jalinei/SPIN/KiCAD_files/spin.kicad_pcb

## KiCad design KiCAD_files/spin.kicad_pcb (2025-09-29)

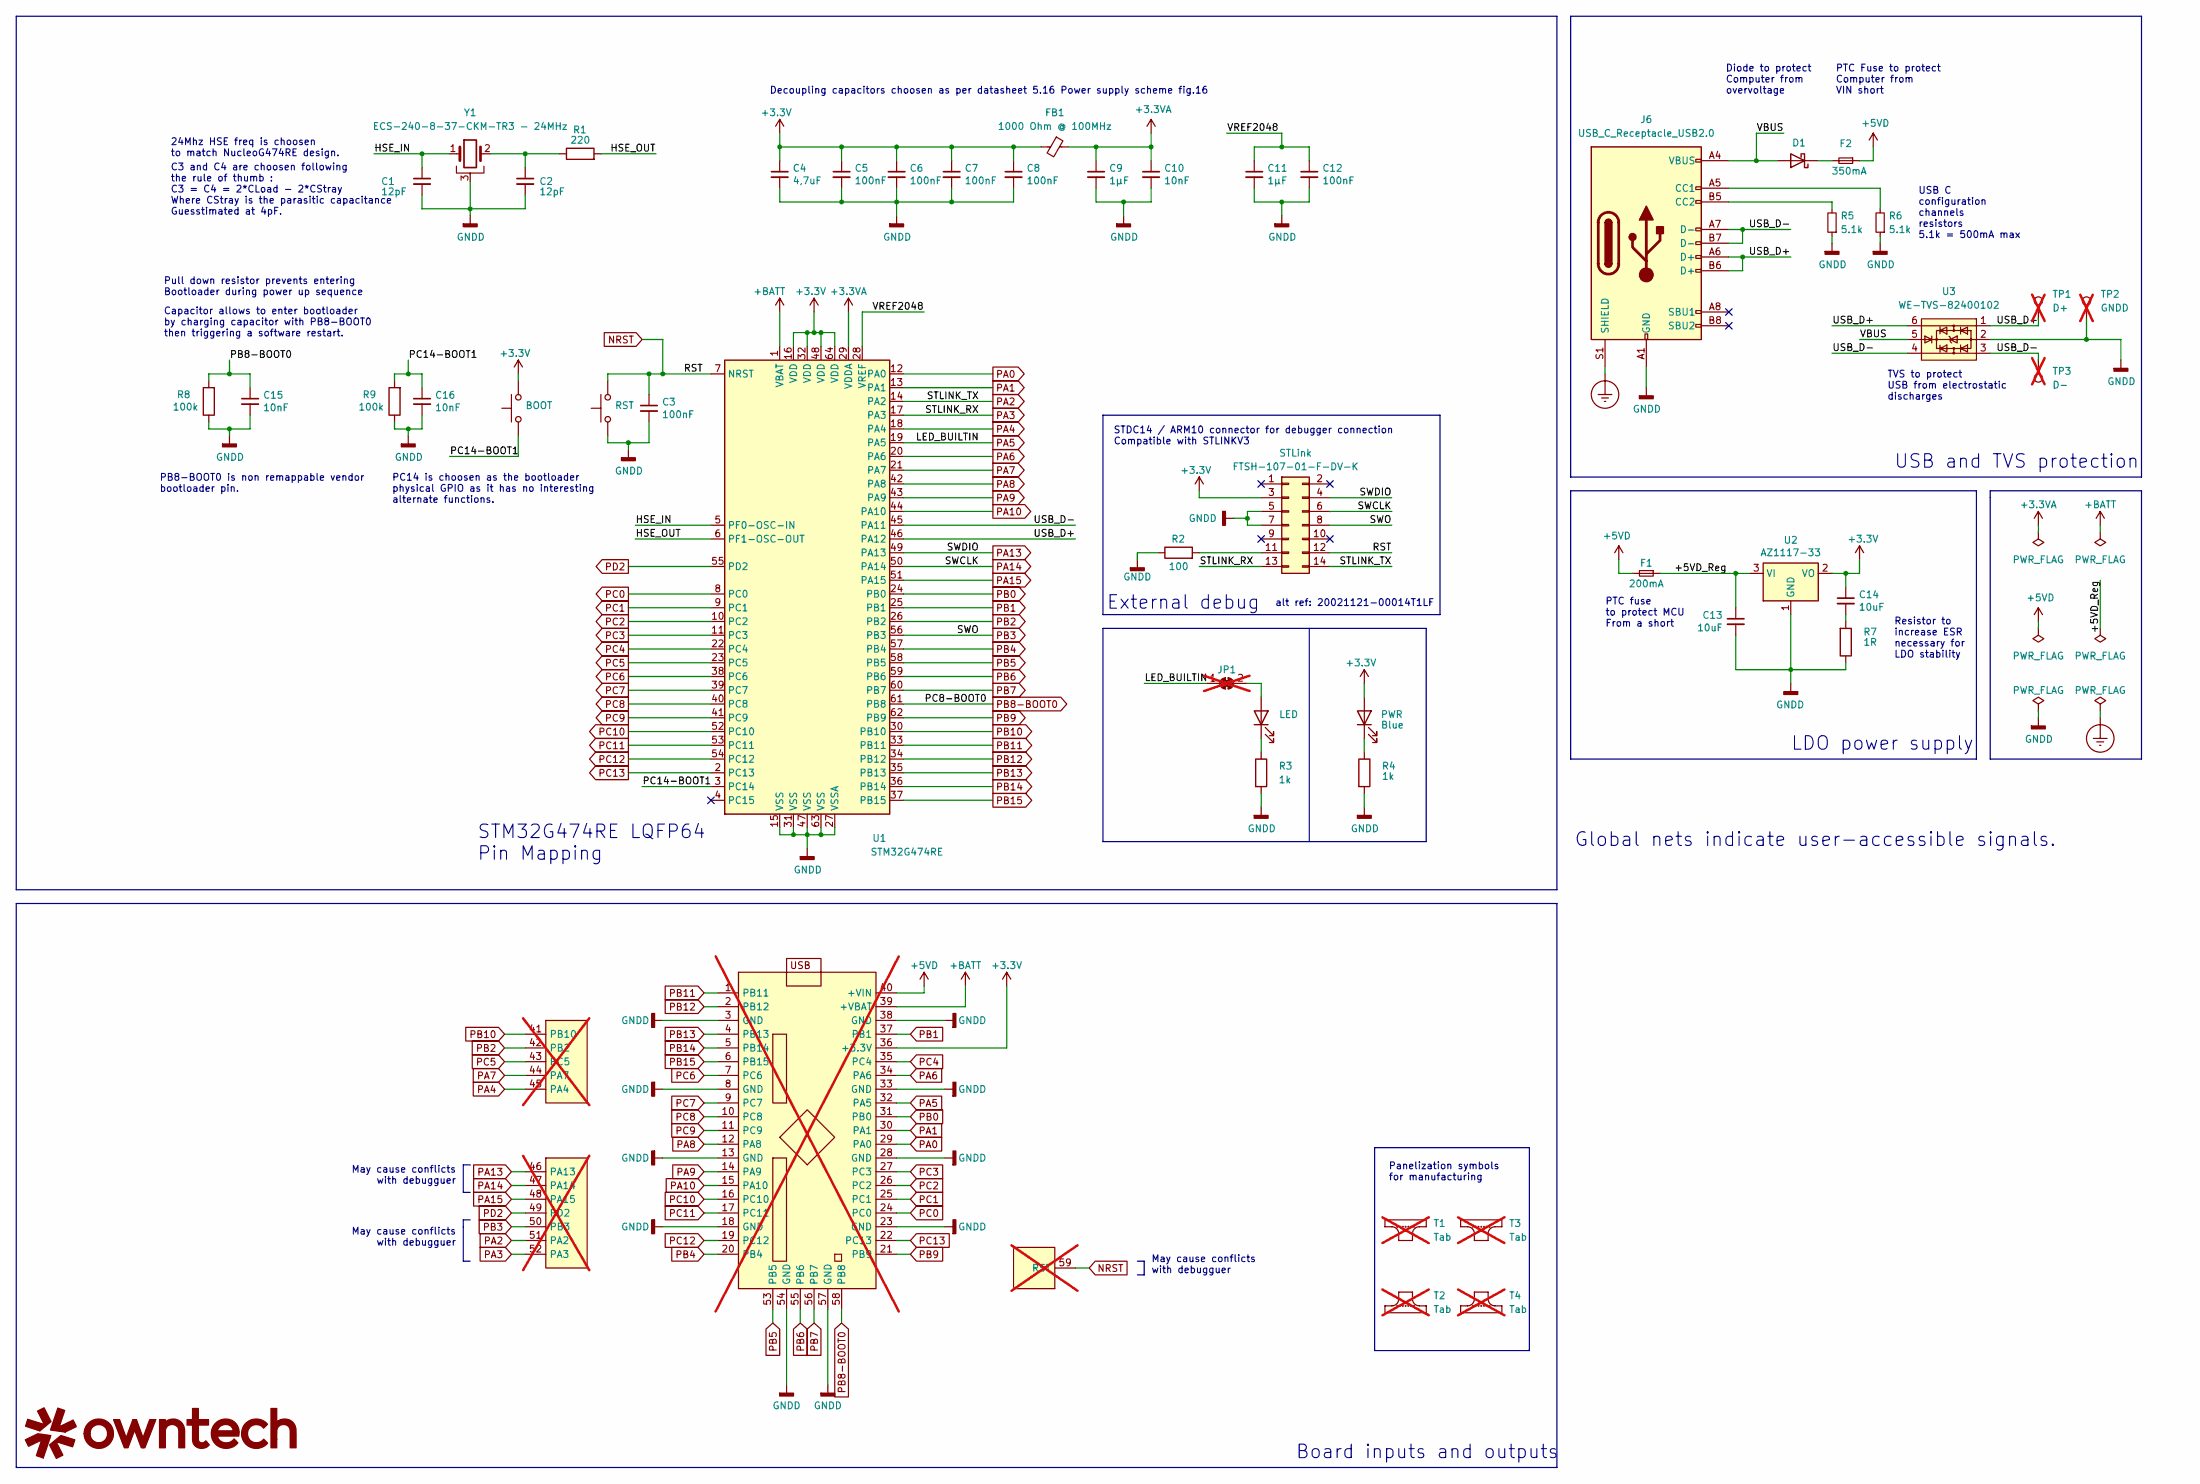
[picture p1: schematic spin.kicad_sch, SPIN V1.2.1]

Parts:
C1, C2: 12pF; C_0402_1005Metric
C3, C5, C6, C7, C8, C12: 100nF; C_0402_1005Metric
C4: 4,7uF; C_0603_1608Metric
C9, C11: 1µF; C_0603_1608Metric
C10, C15, C16: 10nF; C_0402_1005Metric
C13, C14: 10uF; C_0805_2012Metric
D1: RB521S30T1G; D_SOD-523
F1: 200mA; Fuse_0805_2012Metric
F2: 350mA; Fuse_0805_2012Metric
FB1: 1000 Ohm @ 100MHz; R_0402_1005Metric
G1: LOGO; owntech_mini8
J1: OwnTech_SPIN; SPIN_castellated_holes_board; not fitted
J5: FTSH-107-01-F-DV-K; PinHeader_2x07_P1.27mm_Vertical_SMD
J6: USB_C_Receptacle_USB2.0; USB_C_Receptacle_HRO_TYPE-C-31-M-12-reduce-courtyard
JP1: SolderJumper_2_Bridged; SolderJumper-2_P1.0mm_Bridged_RoundedPad0.55x1.0mm_small; not fitted
LED1, LED2: Blue; LED_0805_2012Metric
R1: 220; R_0402_1005Metric
R2: 100; R_0402_1005Metric
R3, R4: 1k; R_0402_1005Metric
R5, R6: 5.1k; R_0402_1005Metric
R7: 1R; R_0402_1005Metric
R8, R9: 100k; R_0402_1005Metric
SW1, SW2: Push Button; SW_SPST_PTS810
T1, T2, T3, T4: Tab; not fitted
TP1: D+; TestPoint_Pad_D1.0mm; not fitted
TP2: GNDD; TestPoint_Pad_D1.0mm; not fitted
TP3: D-; TestPoint_Pad_D1.0mm; not fitted
U1: STM32G474RE; LQFP-64_10x10mm_P0.5mm
U2: AZ1117-33; SOT-89-3
U3: WE-TVS-82400102; SOT-23-6
Y1: ECS-240-8-37-CKM-TR3 - 24MHz; Crystal_SMD_2016-4Pin_ComGnd_2.0x1.6mm

Connections:
+3.3V: C4.1, C5.1, C6.1, C7.1, C8.1, C14.1, FB1.2, J1.36 (+3.3V), J5.3, LED2.2 (A), SW1.1, U1.16 (VDD), U1.32 (VDD), U1.48 (VDD), U1.64 (VDD), U2.2 (VO)
+3.3VA: C9.1, C10.1, FB1.1, U1.29 (VDDA)
+5VD: F1.2, F2.1, J1.40 (+VIN)
+BATT: J1.39 (+VBAT), U1.1 (VBAT)
/+5VD_Reg: C13.1, F1.1, U2.3 (VI)
/HSE_IN: C1.1, U1.5 (PF0-OSC-IN), Y1.1
/HSE_OUT: R1.2, U1.6 (PF1-OSC-OUT)
/PC14-BOOT1: C16.1, R9.2, SW1.2, U1.3 (PC14)
/USB_D+: J6.A6 (D+), J6.B6 (D+), TP1.1, U1.46 (PA12), U3.1, U3.6
/USB_D-: J6.A7 (D-), J6.B7 (D-), TP3.1, U1.45 (PA11), U3.3, U3.4
/VBUS: D1.2 (A), J6.A4 (VBUS), J6.A9 (VBUS), J6.B4 (VBUS), J6.B9 (VBUS), U3.5
/VREF2048: C11.1, C12.1, U1.28 (VREF)
Earth_Protective: J6.S1 (SHIELD)
GNDD: C1.2, C2.2, C3.2, C4.2, C5.2, C6.2, C7.2, C8.2, C9.2, C10.2, C11.2, C12.2, C13.2, C15.2, C16.2, J1.3 (GND), J1.8 (GND), J1.13 (GND), J1.18 (GND), J1.23 (GND), J1.28 (GND), J1.33 (GND), J1.38 (GND), J1.54 (GND), J1.57 (GND), J5.5, J5.7, J6.A1 (GND), J6.A12 (GND), J6.B1 (GND), J6.B12 (GND), R2.1, R3.2, R4.2, R5.1, R6.1, R7.1, R8.1, R9.1, SW2.1, TP2.1, U1.15 (VSS), U1.27 (VSSA), U1.31 (VSS), U1.47 (VSS), U1.63 (VSS), U2.1 (GND), U3.2, Y1.3
NRST: C3.1, J1.59 (RST), J5.12, SW2.2, U1.7 (NRST)
unnamed: C2.1, R1.1, Y1.2
unnamed: C14.2, R7.2
unnamed: D1.1 (K), F2.2
unnamed: J5.11, R2.2
unnamed: J6.A5 (CC1), R6.2
unnamed: J6.B5 (CC2), R5.2
unnamed: JP1.2 (B), LED1.2 (A)
unnamed: LED1.1 (K), R3.1
unnamed: LED2.1 (K), R4.1
PA0: J1.29 (PA0), U1.12 (PA0)
PA1: J1.30 (PA1), U1.13 (PA1)
PA2: J1.51 (PA2), J5.14, U1.14 (PA2)
PA3: J1.52 (PA3), J5.13, U1.17 (PA3)
PA4: J1.45 (PA4), U1.18 (PA4)
PA5: J1.32 (PA5), JP1.1 (A), U1.19 (PA5)
PA6: J1.34 (PA6), U1.20 (PA6)
PA7: J1.44 (PA7), U1.21 (PA7)
PA8: J1.12 (PA8), U1.42 (PA8)
PA9: J1.14 (PA9), U1.43 (PA9)
PA10: J1.15 (PA10), U1.44 (PA10)
PA13: J1.46 (PA13), J5.4, U1.49 (PA13)
PA14: J1.47 (PA14), J5.6, U1.50 (PA14)
PA15: J1.48 (PA15), U1.51 (PA15)
PB0: J1.31 (PB0), U1.24 (PB0)
PB1: J1.37 (PB1), U1.25 (PB1)
PB2: J1.42 (PB2), U1.26 (PB2)
PB3: J1.50 (PB3), J5.8, U1.56 (PB3)
PB4: J1.20 (PB4), U1.57 (PB4)
PB5: J1.53 (PB5), U1.58 (PB5)
PB6: J1.55 (PB6), U1.59 (PB6)
PB7: J1.56 (PB7), U1.60 (PB7)
PB8-BOOT0: C15.1, J1.58 (PB8), R8.2, U1.61 (PB8)
PB9: J1.21 (PB9), U1.62 (PB9)
PB10: J1.41 (PB10), U1.30 (PB10)
PB11: J1.1 (PB11), U1.33 (PB11)
PB12: J1.2 (PB12), U1.34 (PB12)
PB13: J1.4 (PB13), U1.35 (PB13)
PB14: J1.5 (PB14), U1.36 (PB14)
PB15: J1.6 (PB15), U1.37 (PB15)
PC0: J1.24 (PC0), U1.8 (PC0)
PC1: J1.25 (PC1), U1.9 (PC1)
PC2: J1.26 (PC2), U1.10 (PC2)
PC3: J1.27 (PC3), U1.11 (PC3)
PC4: J1.35 (PC4), U1.22 (PC4)
PC5: J1.43 (PC5), U1.23 (PC5)
PC6: J1.7 (PC6), U1.38 (PC6)
PC7: J1.9 (PC7), U1.39 (PC7)
PC8: J1.10 (PC8), U1.40 (PC8)
PC9: J1.11 (PC9), U1.41 (PC9)
PC10: J1.16 (PC10), U1.52 (PC10)
PC11: J1.17 (PC11), U1.53 (PC11)
PC12: J1.19 (PC12), U1.54 (PC12)
PC13: J1.22 (PC13), U1.2 (PC13)
PD2: J1.49 (PD2), U1.55 (PD2)

Notes on the sheet:
PC14 is choosen as the bootloader physical GPIO as it has no interesting alternate functions.
Capacitor allows to enter bootloader by charging capacitor with PB8-BOOT0 then triggering a software restart.
PTC Fuse to protect Computer from VIN short
USB C configuration channels resistors 5.1k = 500mA max
alt ref: 20021121-00014T1LF
Pull down resistor prevents entering Bootloader during power up sequence
STDC14 / ARM10 connector for debugger connection Compatible with STLINKV3
Decoupling capacitors choosen as per datasheet 5.16 Power supply scheme fig.16
LDO power supply
STM32G474RE LQFP64 Pin Mapping
Diode to protect Computer from overvoltage
Global nets indicate user-accessible signals.
PB8-BOOT0 is non remappable vendor bootloader pin.
USB and TVS protection
External debug
TVS to protect USB from electrostatic discharges
Resistor to increase ESR necessary for LDO stability
PTC fuse to protect MCU From a short
May cause conflicts with debugguer
C3 and C4 are choosen following the rule of thumb : C3 = C4 = 2*CLoad - 2*CStray Where CStray is the parasitic capacitance Guesstimated at 4pF.
Panelization symbols for manufacturing
️May cause conflicts with debugguer
Board inputs and outputs
24Mhz HSE freq is choosen to match NucleoG474RE design.

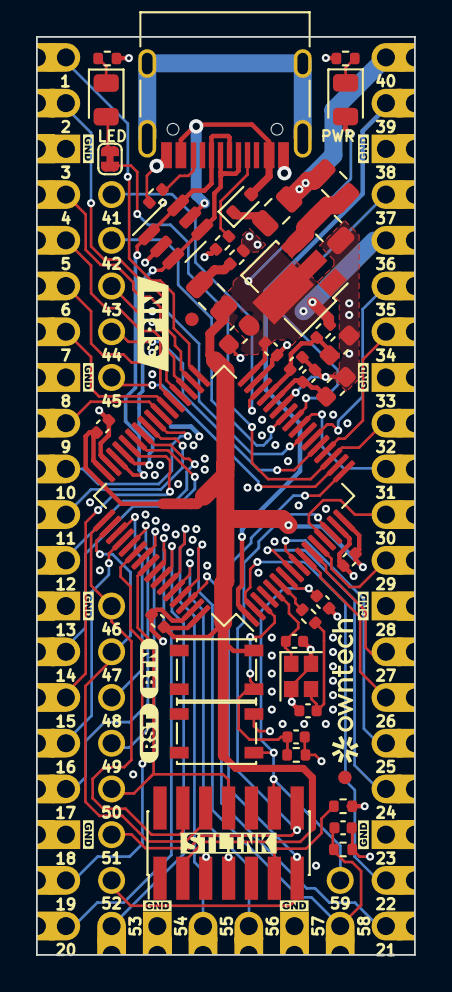
[picture p2: board spin.kicad_pcb from above]

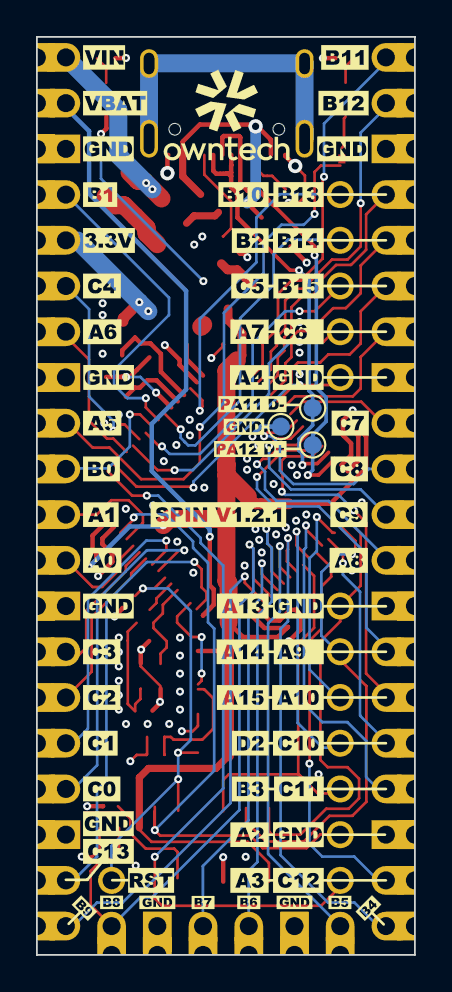
[picture p3: board spin.kicad_pcb from below]

Board: 4 copper layers, 21.0 x 51.0 mm, 126 parts (66 on the bottom side), 68 nets.

Other parts of the board:
kibuzzard-68DA9FF6: G***; kibuzzard-68DA9FF6
kibuzzard-68DA56F7: G***; kibuzzard-68DA56F7
kibuzzard-68DA57E1, kibuzzard-68DA57E1#2, kibuzzard-68DA57E1#3, kibuzzard-68DA57E1#4, kibuzzard-68DA57E1#5, kibuzzard-68DA57E1#6, kibuzzard-68DA57E1#7, kibuzzard-68DA57E1#8: G***; kibuzzard-68DA57E1
kibuzzard-68DA61DB, kibuzzard-68DA61DB#2, kibuzzard-68DA61DB#3, kibuzzard-68DA61DB#4, kibuzzard-68DA61DB#5, kibuzzard-68DA61DB#6, kibuzzard-68DA61DB#7, kibuzzard-68DA61DB#8: G***; kibuzzard-68DA61DB
kibuzzard-68DA61F7: G***; kibuzzard-68DA61F7
kibuzzard-68DA62C4: G***; kibuzzard-68DA62C4
kibuzzard-68DA62D2: G***; kibuzzard-68DA62D2
kibuzzard-68DA62DF: G***; kibuzzard-68DA62DF
kibuzzard-68DA62EF: G***; kibuzzard-68DA62EF
kibuzzard-68DA63D4: G***; kibuzzard-68DA63D4
kibuzzard-68DA63E1: G***; kibuzzard-68DA63E1
kibuzzard-68DA63ED: G***; kibuzzard-68DA63ED
kibuzzard-68DA63F9: G***; kibuzzard-68DA63F9
kibuzzard-68DA64A4: G***; kibuzzard-68DA64A4
kibuzzard-68DA64AE: G***; kibuzzard-68DA64AE
kibuzzard-68DA64B9: G***; kibuzzard-68DA64B9
kibuzzard-68DA64C2: G***; kibuzzard-68DA64C2
kibuzzard-68DA64DC: G***; kibuzzard-68DA64DC
kibuzzard-68DA64F4: G***; kibuzzard-68DA64F4
kibuzzard-68DA67AE: G***; kibuzzard-68DA67AE
kibuzzard-68DA67BA: G***; kibuzzard-68DA67BA
kibuzzard-68DA67CE: G***; kibuzzard-68DA67CE
kibuzzard-68DA67E1: G***; kibuzzard-68DA67E1
kibuzzard-68DA621E: G***; kibuzzard-68DA621E
kibuzzard-68DA627F: G***; kibuzzard-68DA627F
kibuzzard-68DA628C: G***; kibuzzard-68DA628C
kibuzzard-68DA630F: G***; kibuzzard-68DA630F
kibuzzard-68DA631E: G***; kibuzzard-68DA631E
kibuzzard-68DA634D: G***; kibuzzard-68DA634D
kibuzzard-68DA636F: G***; kibuzzard-68DA636F
kibuzzard-68DA643B: G***; kibuzzard-68DA643B
kibuzzard-68DA645C: G***; kibuzzard-68DA645C
kibuzzard-68DA679F, kibuzzard-68DA679F#2: G***; kibuzzard-68DA679F
kibuzzard-68DA685D: G***; kibuzzard-68DA685D
kibuzzard-68DA687C: G***; kibuzzard-68DA687C
kibuzzard-68DA5684: G***; kibuzzard-68DA5684
kibuzzard-68DA5768, kibuzzard-68DA5768#2: G***; kibuzzard-68DA5768
kibuzzard-68DA6234: G***; kibuzzard-68DA6234
kibuzzard-68DA6241: G***; kibuzzard-68DA6241
kibuzzard-68DA6253: G***; kibuzzard-68DA6253
kibuzzard-68DA6266: G***; kibuzzard-68DA6266
kibuzzard-68DA6304: G***; kibuzzard-68DA6304
kibuzzard-68DA6335: G***; kibuzzard-68DA6335
kibuzzard-68DA6341: G***; kibuzzard-68DA6341
kibuzzard-68DA6374: G***; kibuzzard-68DA6374
kibuzzard-68DA6386: G***; kibuzzard-68DA6386
kibuzzard-68DA6390: G***; kibuzzard-68DA6390
kibuzzard-68DA6416: G***; kibuzzard-68DA6416
kibuzzard-68DA6452: G***; kibuzzard-68DA6452
kibuzzard-68DA6470: G***; kibuzzard-68DA6470
kibuzzard-68DA6496: G***; kibuzzard-68DA6496
kibuzzard-68DA6750: G***; kibuzzard-68DA6750
kibuzzard-68DA6783: G***; kibuzzard-68DA6783
kibuzzard-68DA6850: G***; kibuzzard-68DA6850
kibuzzard-68DAA3CB: G***; kibuzzard-68DAA3CB
kibuzzard-68DAA3D4: G***; kibuzzard-68DAA3D4
kibuzzard-68DAA5C2: G***; kibuzzard-68DAA5C2
kibuzzard-68DAA085: G***; kibuzzard-68DAA085
kibuzzard-68DAA579: G***; kibuzzard-68DAA579
kibuzzard-68DAA604: G***; kibuzzard-68DAA604
kibuzzard-657AFF8A: G***; kibuzzard-657AFF8A
